roboticsuic/Walk-Engine/CONTACT_US.md

This project remains as an open source for whoever wants to reproduce it.  It has been used as a university project and will be a pleasure to us if someone would really use it or either improve it for functional applications. In addition, we would be thrilled if any patient improves its quality life because of our work.
Do not doubt to contact us for any further information:
- Andrea Garcia Ropero: andreagarciaropero@uic.es
- Berta Nieto González: berta.nieto@uic.es
- Pau Vilanova Corrales: pau.vilanova@uic.es
- Pedro Arancón Farrás: p.arancon@uic.es
