roboticsuic/Walk-Engine/scheme/scheme_code.png

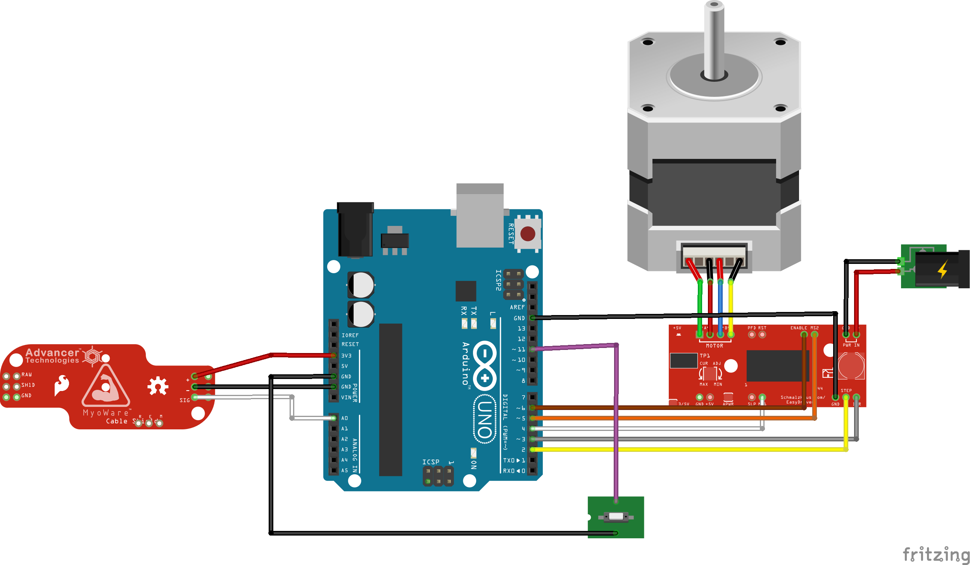
scheme/scheme_code.png
