roboticsuic/Walk-Engine/3Dfiles/Arandela.SLDPRT

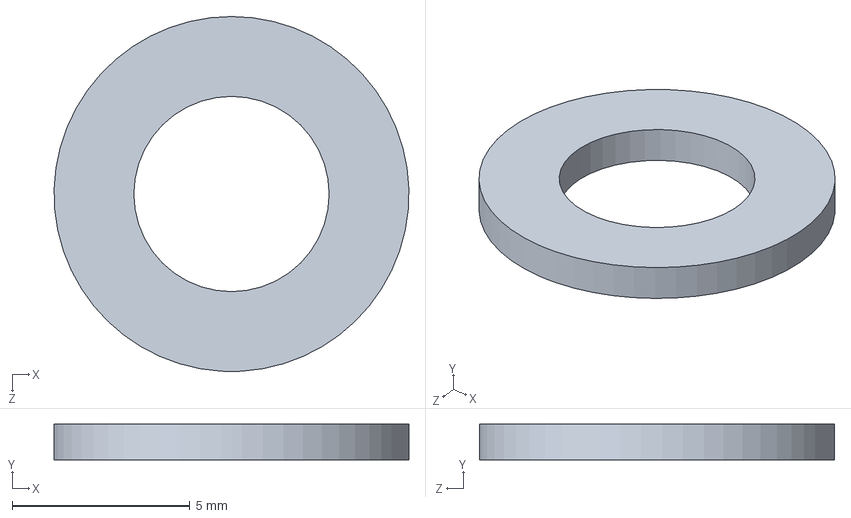
[picture p14: CAD file, 2021-05-29]
3Dfiles/Arandela.SLDPRT
10.00 x 1.00 x 10.0 mm
