roboticsuic/Walk-Engine/3Dfiles/6-shank-bawah-metal-material (1).SLDPRT

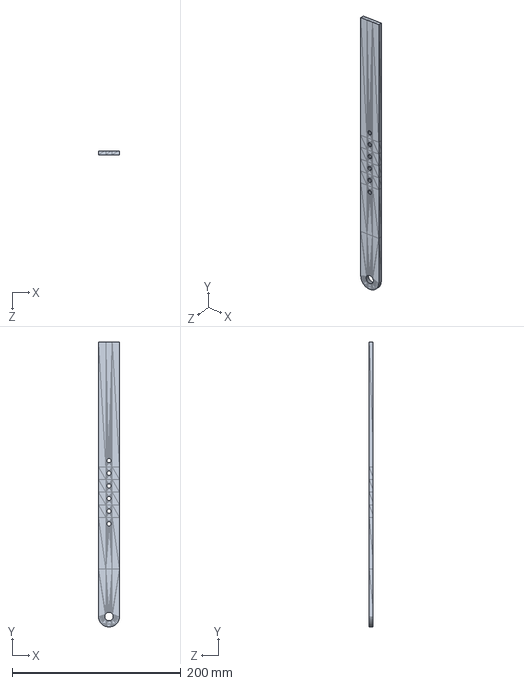
[picture p15: CAD file, 2021-05-29]
3Dfiles/6-shank-bawah-metal-material (1).SLDPRT
25.0 x 338.3 x 4.50 mm
