roboticsuic/Walk-Engine/(list of files, cad)

Other CAD files:
3Dfiles/.STL
